vic80-designs/vic80_attiny2313-2x18b20-thermostat/README.md

# 🌡 Двухканальный термостат на ATtiny2313 с энкодером (asm)

Универсальный двухканальный термостат с управлением инкрементальным энкодером, написанный на чистом модульном ассемблере AVR. Проект разработан более 10 лет назад и успешно проверен длительной реальной эксплуатацией.

Предназначен для автоматического управления климатом и защиты отопительных систем или электроприборов от перегрева. Подходит как для водяных бойлеров (контроль жидкого теплоносителя), так и для электрических конвекторов (контроль сухого ТЭНа).

## 🚀 Ключевые особенности
* **Аппаратный минимализм:** Всё реализовано на одной ATtiny2313, где опрос датчиков, обработка ввода и динамическая индикация работают напрямую, без сдвиговых регистров и дешифраторов.
* **Логика работы «И / ИЛИ»:** Включение нагрева происходит только по условию логического И (когда остыли оба датчика), а выключение — по логическому ИЛИ (как только один из датчиков достиг предела).
* **Система самодиагностики:** Мгновенное обесточивание нагрузки при обрыве или неисправности датчиков с выводом аварийного кода `Er1` (сбой Д1), `Er2` (сбой Д2) или `Er3` (сбой обоих датчиков).
* **Конфигурация дисплея:** Быстрая адаптация кода под индикаторы с Общим Анодом (ОА) или Общим Катодом (ОК) изменением всего одного дефайна в начале исходного кода.
* **Эстетичный интерфейс:** Поддержка отрицательных температур с динамическим сдвигом знака «минус» вплотную к числу для вывода ` -1` или `-10` без отрыва знака от цифры.
* **Удобство отладки:** Разведение стандартного разъема IDC-10 на плате для внутрисхемного программирования (ISP), что позволяет легко обновлять HEX/EEP файлы и настраивать фьюзы.

## 📊 Алгоритм контроля температуры
1. **Включение нагрузки (Логическое И):** Датчик 1 (Теплоноситель/ТЭН) < (Уставка 1 - Гистерезис 1) **И** Датчик 2 (Воздух) < (Уставка 2 - Гистерезис 2).
2. **Выключение нагрузки (Логическое ИЛИ):** Датчик 1 >= Уставка 1 **ИЛИ** Датчик 2 >= Уставка 2.

## 🛠 Инженерное меню (Параметры)
Вход осуществляется удержанием кнопки энкодера более 3 секунд.
* **П-1:** Верхнее ограничение для уставки датчика 2 (Воздух). *Диапазон: 0...45 °C*.
* **П-2:** Гистерезис датчика 2 (Воздух). *Диапазон: 1...10 °C*.
* **П-3:** Уставка температуры для датчика 1 (Теплоноситель/ТЭН). *Диапазон: 10...127 °C*.
* **П-4:** Гистерезис датчика 1 (Теплоноситель/ТЭН). *Диапазон: 1...20 °C*.

## 📁 Структура репозитория
* `📁 Firmware/Bin` — готовые скомпилированные файлы прошивок отдельно для индикаторов с Общим Анодом (`Thermostat_CA.hex`) и Общим Катодом (`Thermostat_CC.hex`), а также файл инициализации памяти `Thermostat.eep`.
* `📁 Firmware/Source_Code` — полноценное модульное решение для Microchip Studio (Atmel Studio) со всеми исходниками на ассемблере, разбитыми по функциональным узлам (`/DynIndik`, `/Encoder`, `/OWI`, `/Buttons` и т.д.).
* `📁 Schematics` — принципиальная схема устройства, представленная в форматах **PDF** (для качественной печати) и **PNG** (для быстрого просмотра в браузере). По умолчанию схема сконфигурирована под Общий Катод (ОК).
* `📁 PCB` — Файлы печатной платы: Gerber-архив в формате .zip для заказа плат на заводе и изображения слоев.

## ⚙ Настройка Fuse-битов при прошивке (Критически важно!)

Для стабильной работы таймингов ассемблерного кода и защиты от зависаний при холодном старте, ATtiny2313 должен тактоваться от внутреннего RC-осциллятора 8.0 МГц (без делителя) с включенным BOD 4.3V. Используйте значения: **LF:0xE4, HF:0x99, EF:0xFF**.

| Программа / Метод | Low Fuse | High Fuse | Ext. Fuse |
| :--- | :---: | :---: | :---: |
| **AVRDUDE / Консоль** | **0xE4** | **0x99** | **0xFF** |
| **eXtreme Burner** *(прямая запись)* | **0xE4** | **0x99** | **0xFF** |
| **AVR8 Burn-O-Mat** | **E4** | **99** | **FF** |

### ⚠ Важные предупреждения по софту:
1.  **AVR8 Burn-O-Mat:** В настройках *Start-up time* выберите **slowly rising power** (14CK + 64ms). Не активируйте пункт *"brown out detection enabled"* отдельно, чтобы не получить ошибочный `0xC4`.
2.  **eXtreme Burner:** В отличие от ATmega8, здесь байты вносятся в прямом виде, без инверсии.

### 💾 КРИТИЧЕСКИ ВАЖНО ПРИ ПРОШИВКЕ

* **Обязательная прошивка EEPROM**
В коде микроконтроллера ради жесткой экономии памяти отсутствует функция автоматической инициализации ячеек «из коробки». Поэтому помимо файлов `.hex`, **ОБЯЗАТЕЛЬНО** нужно записать файл `Thermostat.eep` в энергонезависимую память (EEPROM) микроконтроллера. Если этого не сделать, при первом старте рабочие уставки и лимиты будут заполнены некорректными значениями по умолчанию (`0xFF`), что приведет к выходу параметров за границы инженерных диапазонов и нарушению логики работы устройства.

* **Контроль фьюз-бита EESAVE**
При конфигурировании фьюзов обязательно убедитесь, что бит `EESAVE` находится в запрограммированном состоянии (в значении `hfuse = 0x99` он уже активен). Этот бит защищает память EEPROM от стирания при полной очистке чипа. Если его отключить, то при любом последующем обновлении управляющей программы все ваши настроенные через сервисное меню калибровки и гистерезисы будут полностью утеряны.

## 🔌 Рекомендации по источнику питания и фильтрации
* **Выбор БП:** Настоятельно не рекомендуется использовать ультракомпактные модули питания типа **Hi-Link (HLK-PM01)**. Практическая эксплуатация показала, что они генерируют мощные высокочастотные (ВЧ) помехи в момент старта. Для стабильной работы лучше применять качественные линейные трансформаторы или импульсные адаптеры со схемой понижающего стабилизатора.
* **Модификация схемы (Дроссель):** В текущей ревизии печатной платы сглаживающий дроссель отсутствует. При сборке термостата на базе импульсных БП крайне рекомендуется самостоятельно установить в разрыв плюсовой линии питания 5В (после электролита 1000 мкФ, но до блокировочной керамики 0.1 мкФ у ног микроконтроллера) SMD-дроссель номиналом **22–47 мкГн** (маркировка `220` или `470`). Это защитит кристалл от ВЧ-грязи по питанию на физическом уровне. 
* **Программная защита:** В текущую версию кода добавлена софтверная защита от ВЧ-помех импульсных БП — принудительный сброс регистров флагов `TIFR` и `GIFR` в точке софт-старта непосредственно перед вызовом команды `sei`.

## ⚠️ Дисклеймер и техническое примечание

**Проект предоставляется по принципу «As Is» (Как есть).** Автор не несет ответственности за использование устройства, сборка производится на ваш страх и риск. При распространении или модификации кода указание авторства (**vic80**) обязательно.

**Технический нюанс:** Данная схема — это низковольтный блок управления («голова» устройства) с оптической развязкой на MOC, без силовых элементов на борту. Подключение силовой части и разводка 230V осуществляется пользователем самостоятельно. Рекомендуется использовать аппаратные меры безопасности (например, термопредохранитель) и не оставлять работающий прибор без присмотра.
