vic80-designs/vic80_attiny2313-2x18b20-thermostat/Schematics/Schematic_thermostat.png

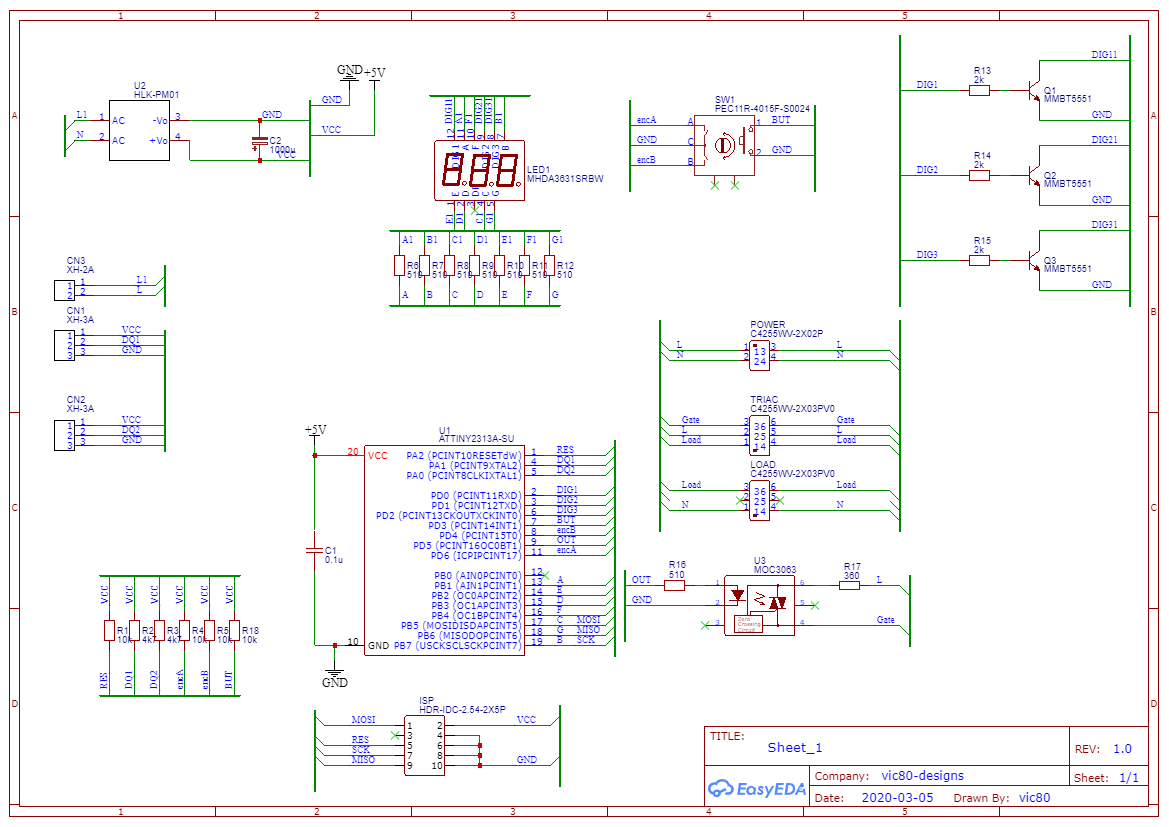
Schematics/Schematic_thermostat.png
